Alex-2-Graf/LGT-Turbo-Sound-emulator/Programmer/AVRDUDESS_PROGRAMMING.png

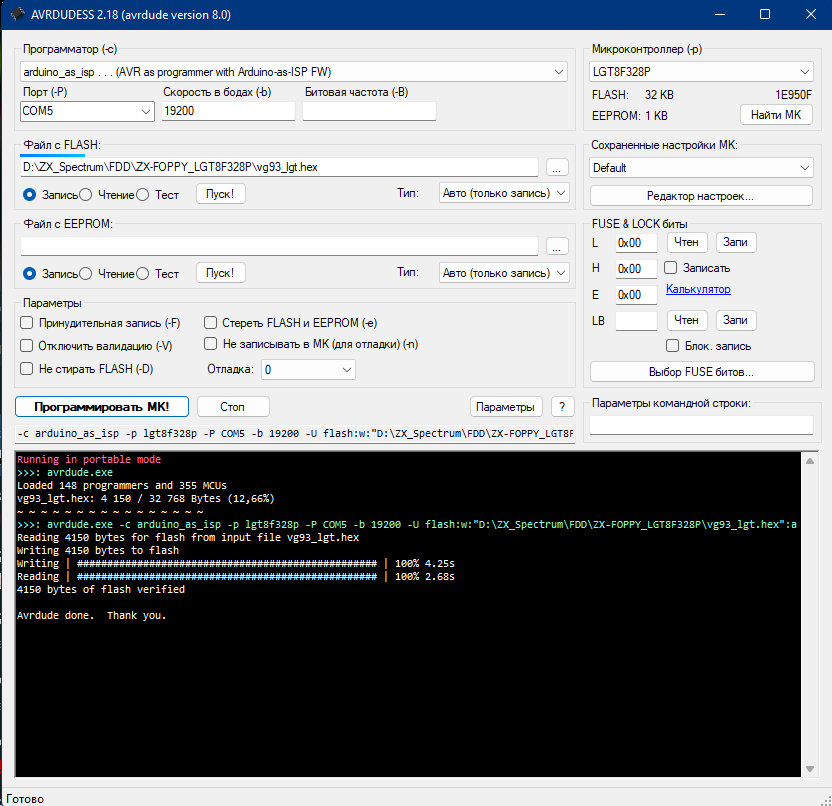
Programmer/AVRDUDESS_PROGRAMMING.png
