Alex-2-Graf/LGT-Turbo-Sound-emulator/Programmer/AVRDUDESS_SETTING.png

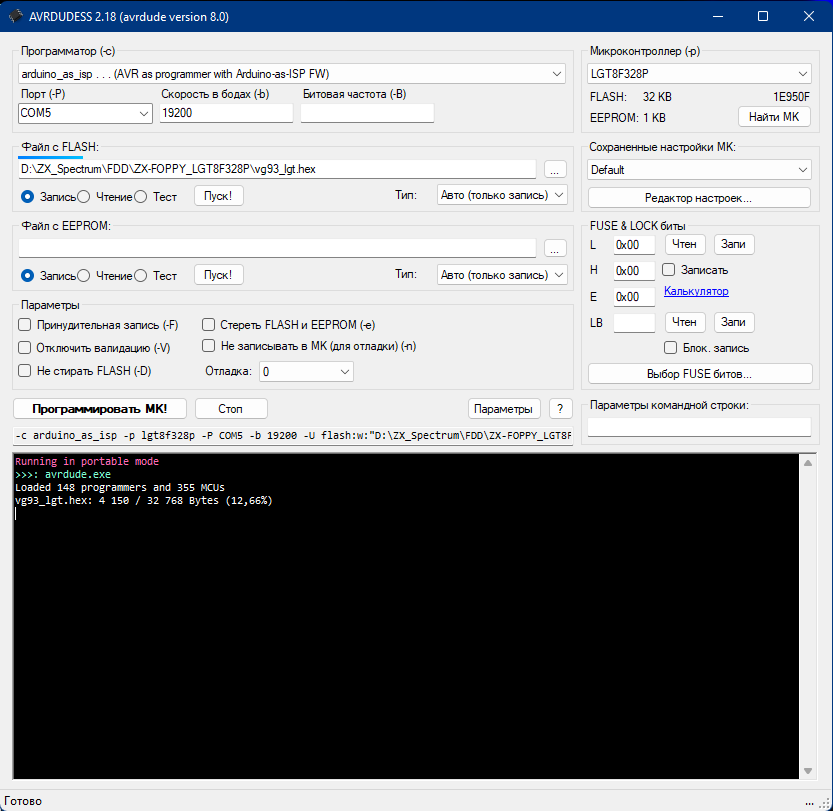
Programmer/AVRDUDESS_SETTING.png
