Alex-2-Graf/LGT-Turbo-Sound-emulator/Export/TurboSound_LGT_40p_Ver3.0.pdf

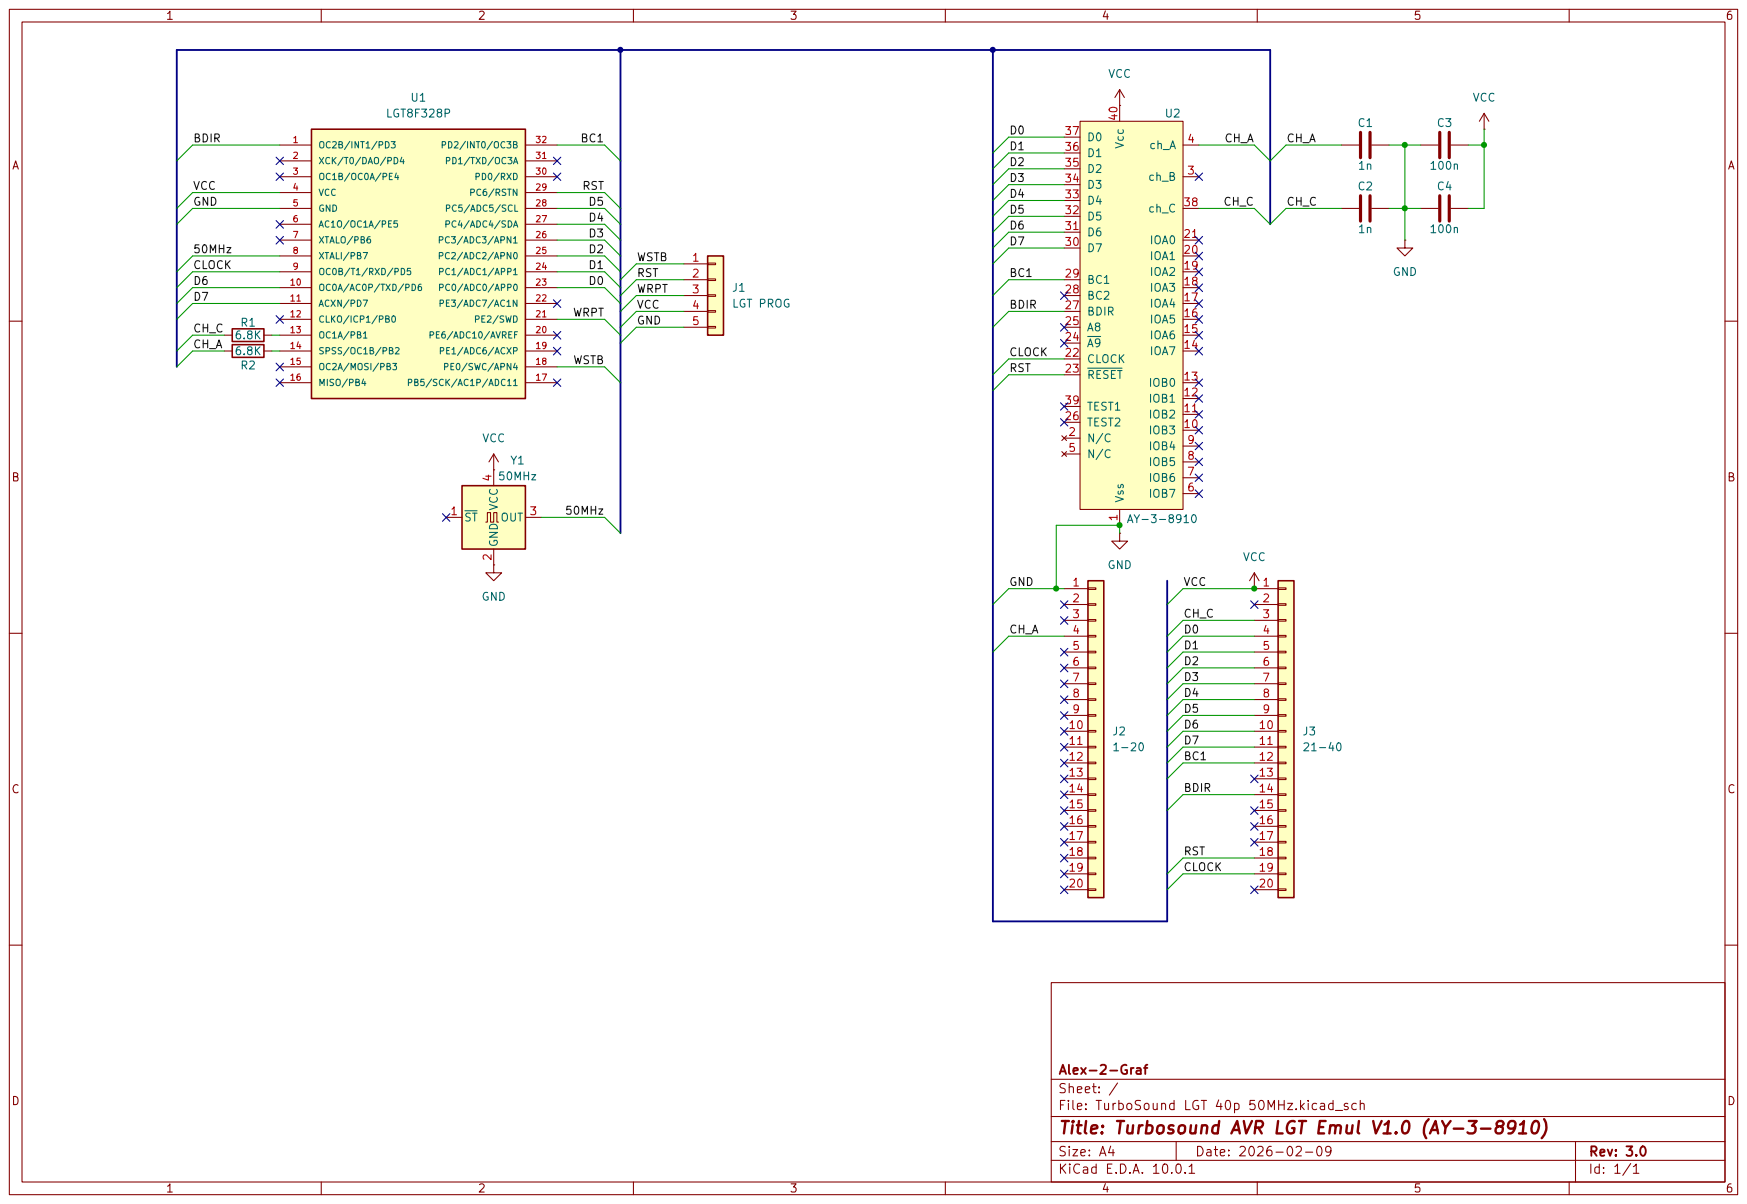
[picture p11: page 1]
