Alex-2-Graf/LGT-Turbo-Sound-emulator/Export/TurboSound_LGT_28p.pdf

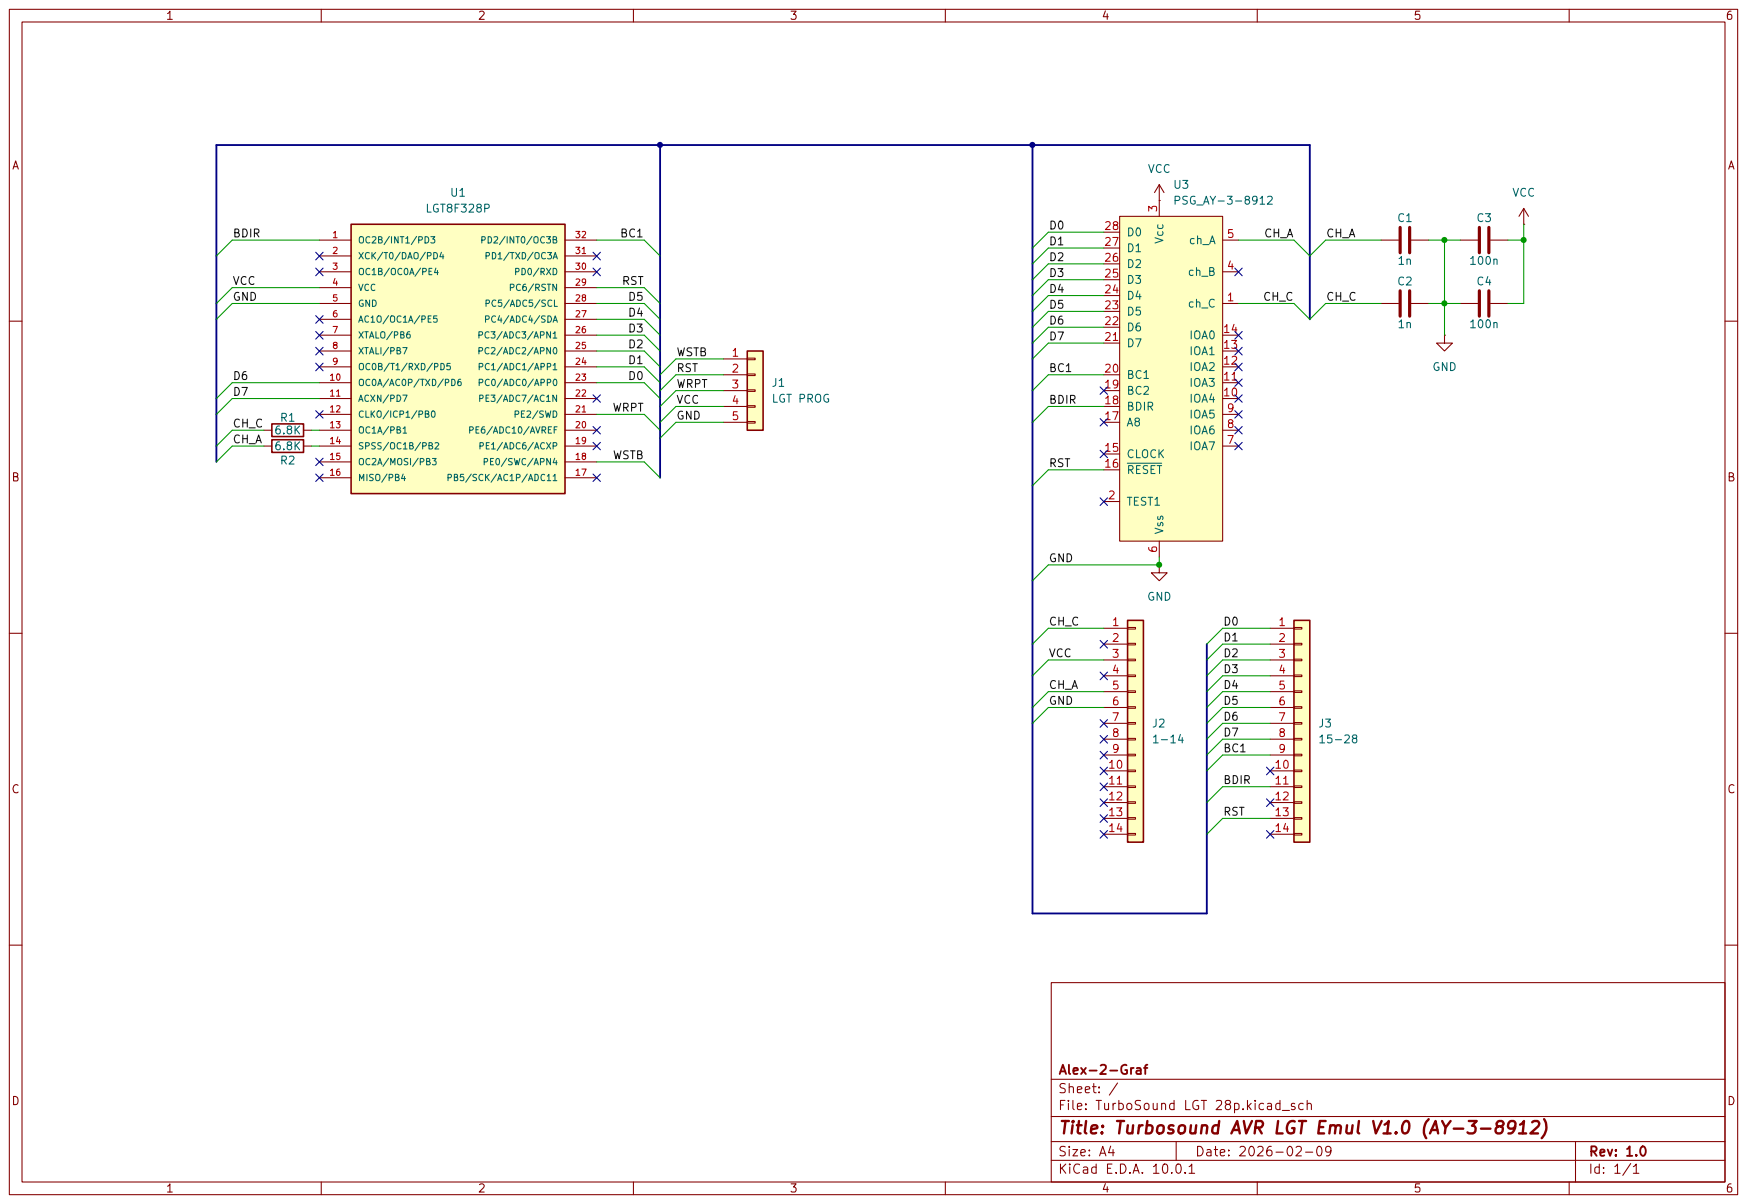
[picture p12: page 1]
