Alex-2-Graf/LGT-Turbo-Sound-emulator/Export/TurboSound_LGT_28p_Ver3.0.pdf

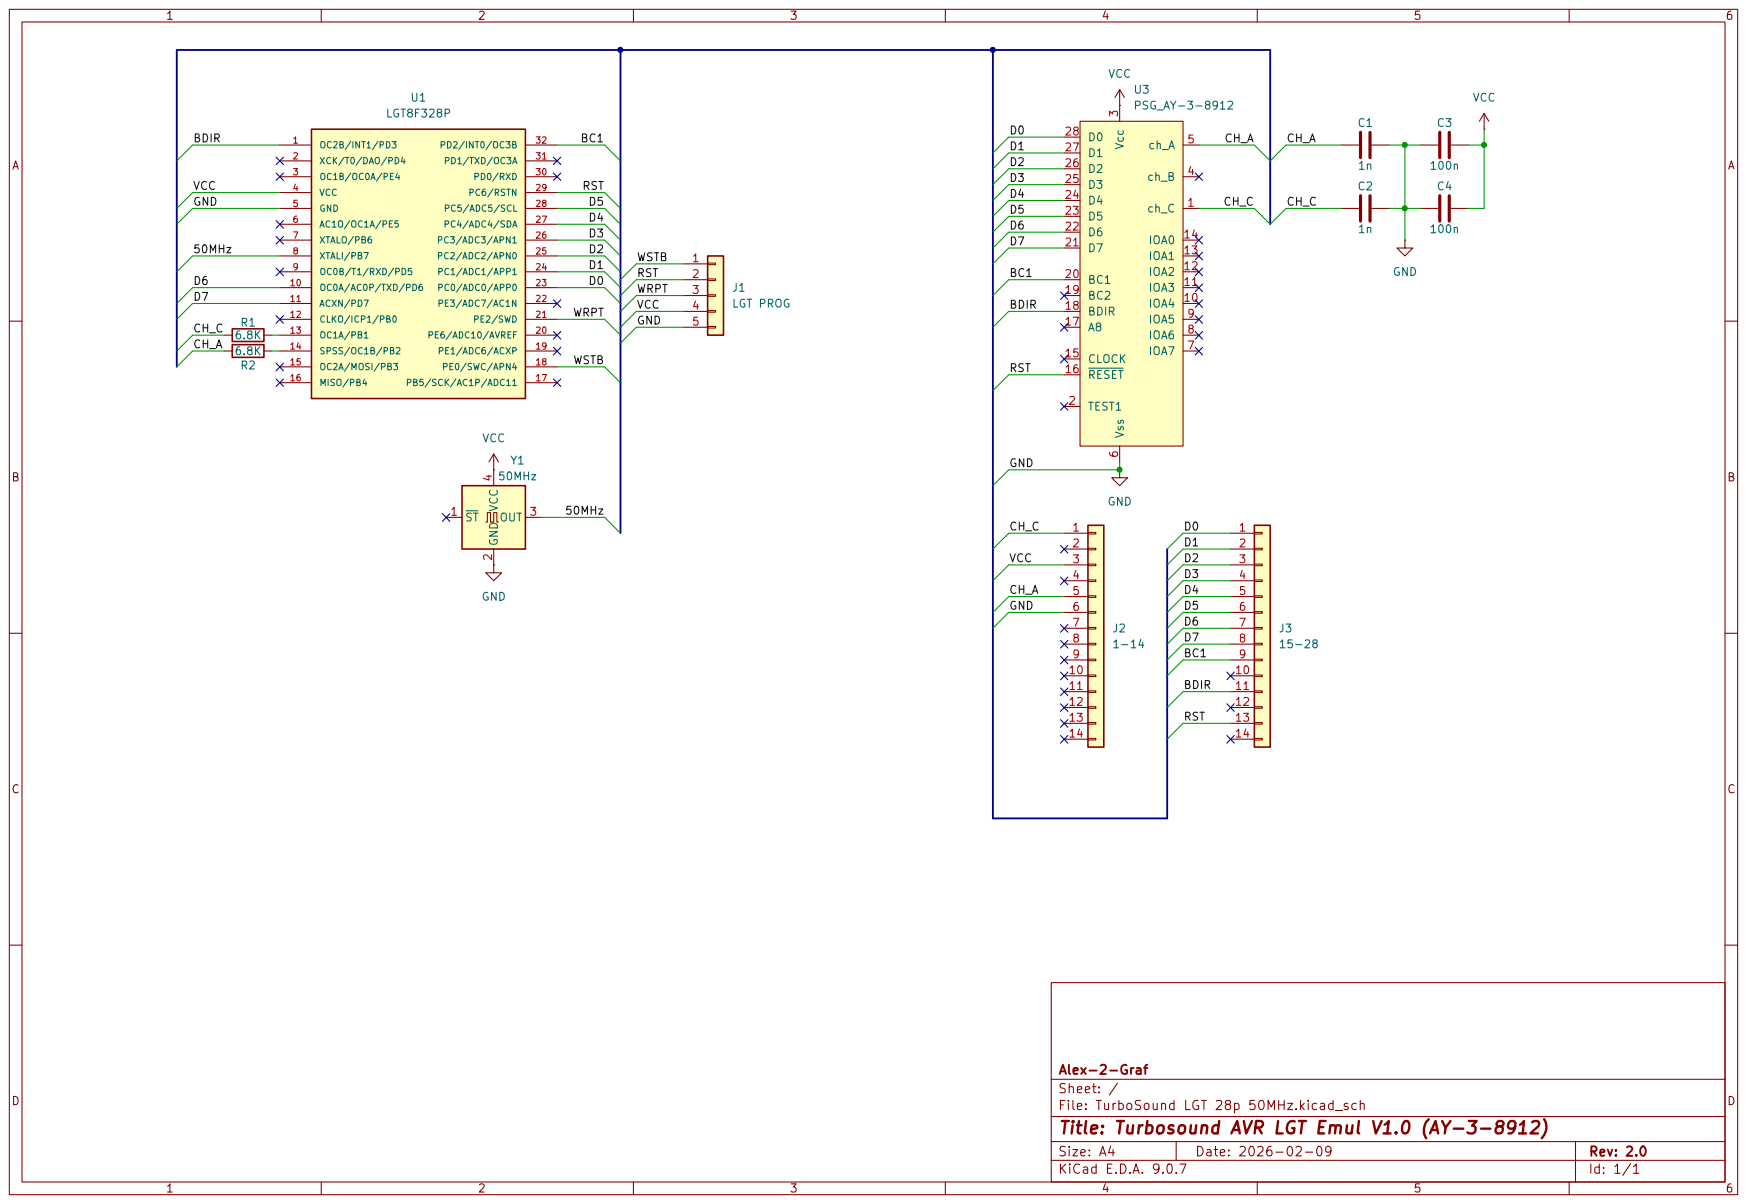
[picture p13: page 1]
