Alex-2-Graf/LGT-Turbo-Sound-emulator/Export/TurboSound_LGT_40p_50MHz.pdf

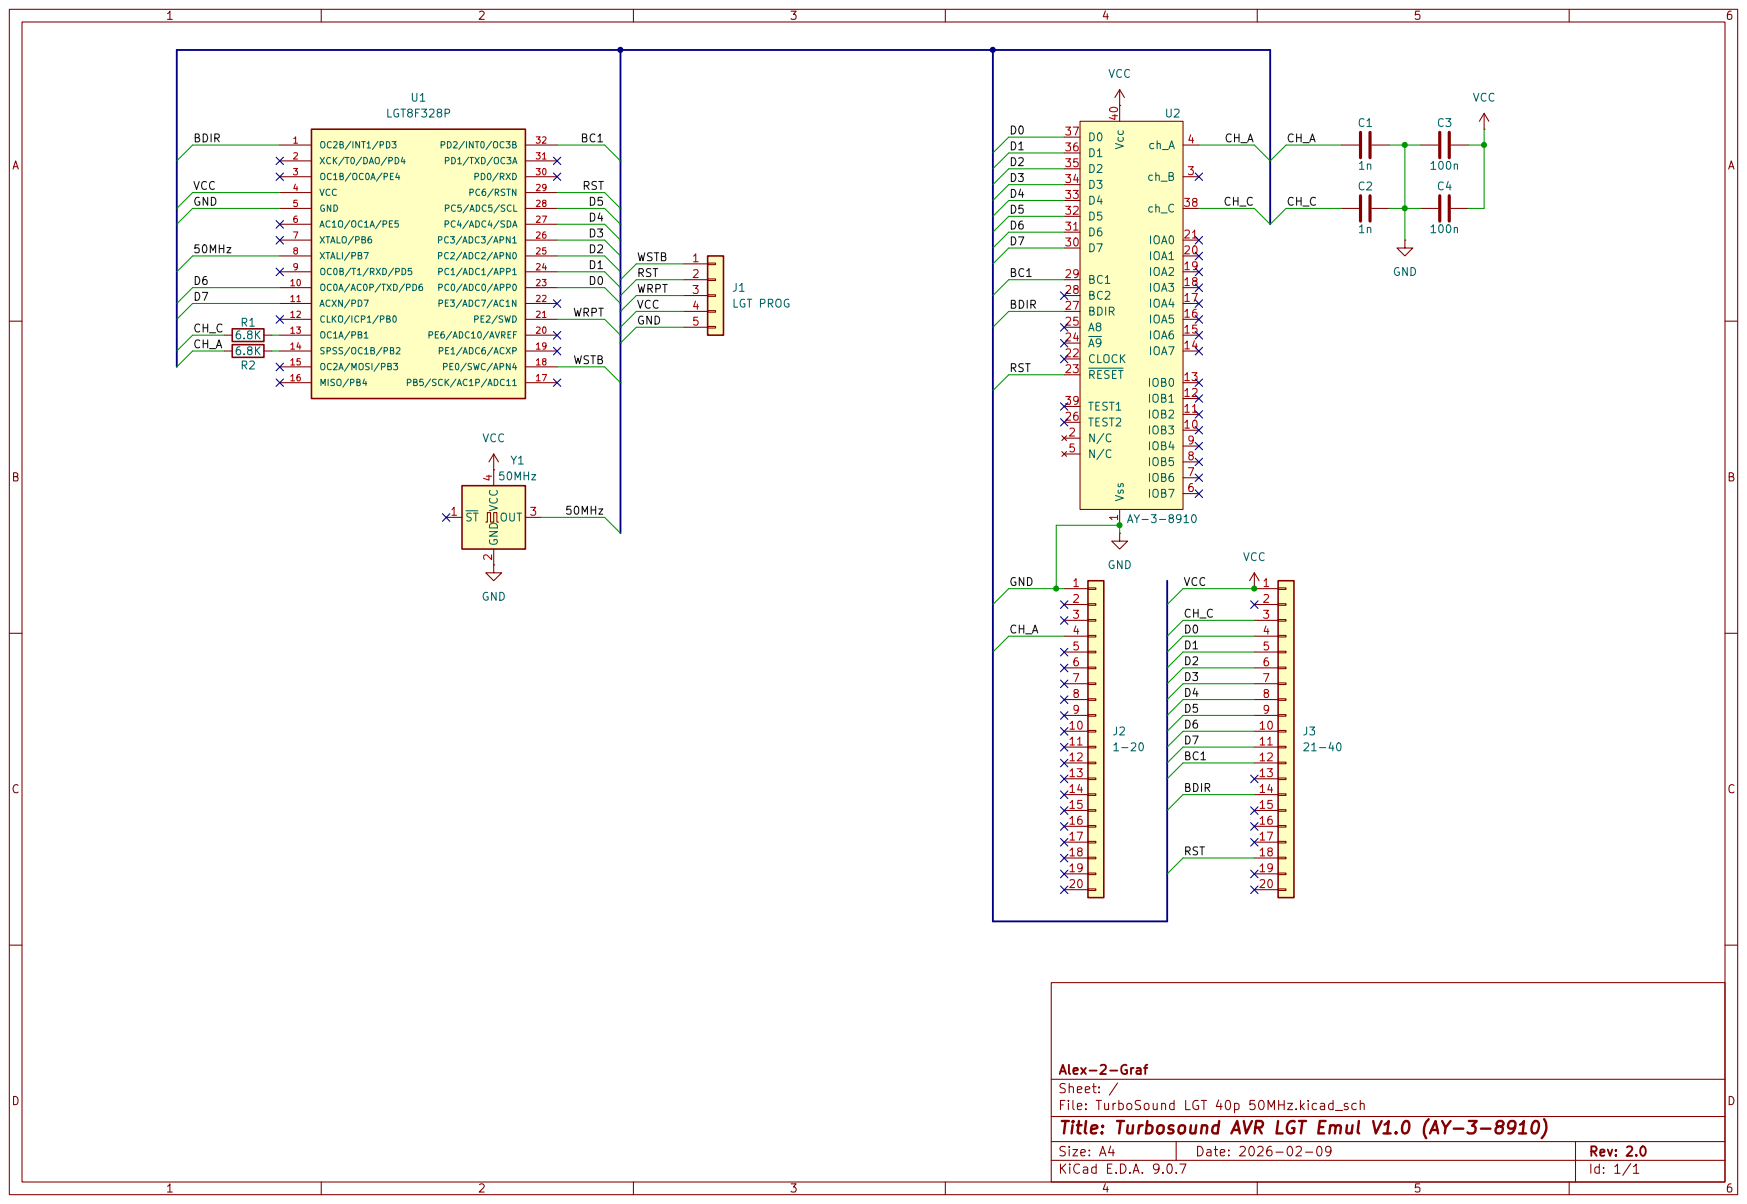
[picture p14: page 1]
