Alex-2-Graf/LGT-Turbo-Sound-emulator/Export/TurboSound_LGT_40p.pdf

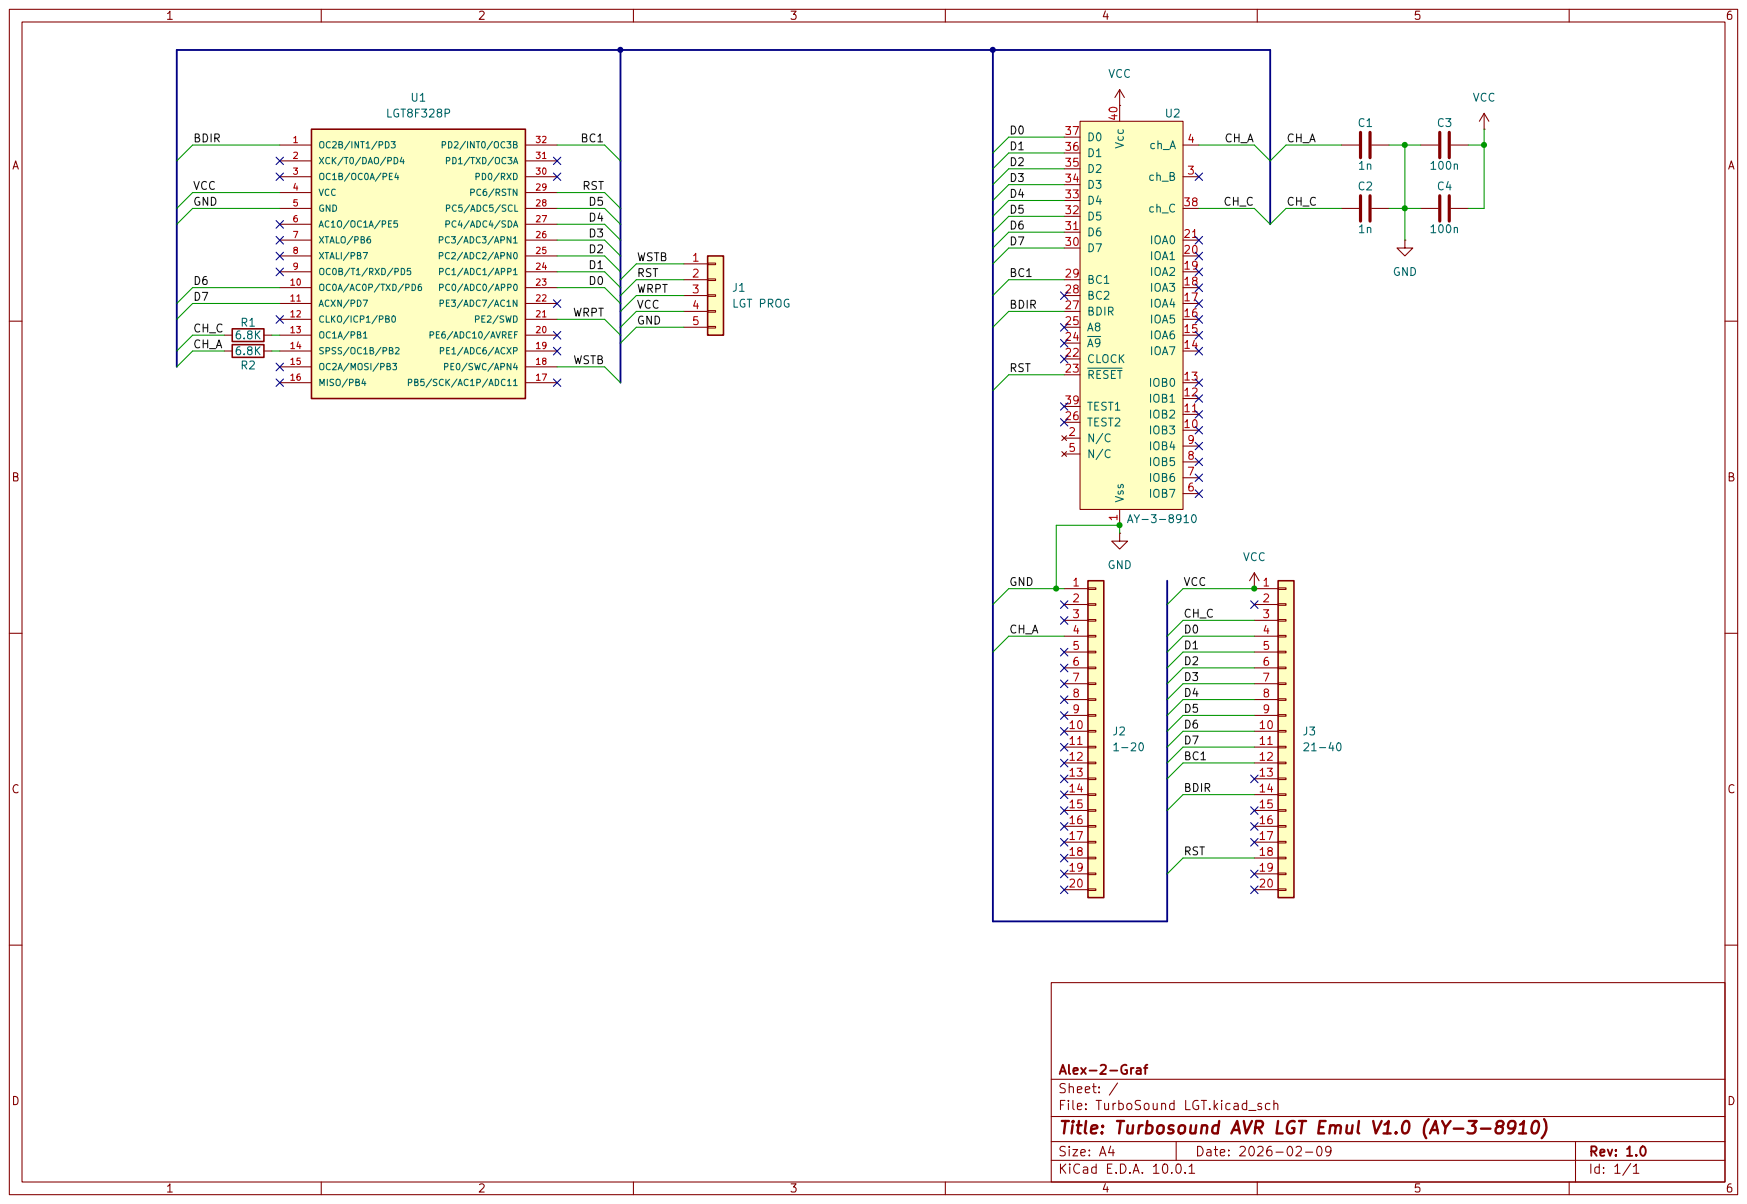
[picture p15: page 1]
